jogme/yetis-keyboard/pictures/version1_1.JPG

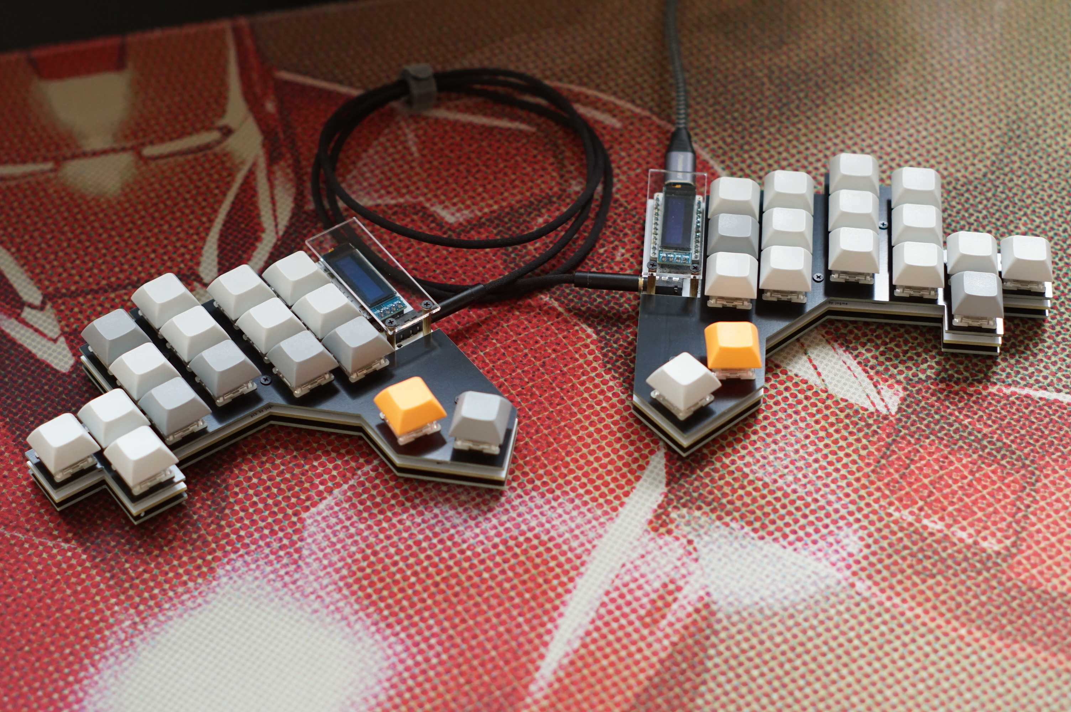
pictures/version1_1.JPG
