jogme/yetis-keyboard/(commit log)

2022-08-23 Initial commit
    - Add layout pics
    - Add scheme for one side
    - Add footprint for one side
    [yeti.kicad_pcb, yeti.kicad_sch]
2022-08-23 Restructe files into directories
    [yeti.kicad_pcb, yeti.kicad_sch]
2022-08-26 Enhancments and adding edge to pcb
    [yeti.kicad_pcb]
2023-02-14 Add case and fix pcb
    [case.FCStd, case_left.FCStd, case_right.FCStd, top_plate.FCStd, top_plate_right.FCStd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]
2023-02-14 pcb: Fix serial pin for jack
    [yeti.kicad_pcb, yeti.kicad_sch]
2023-02-14 pcb: Revert right-hand LED order
    When RGB_MODE_KNIGHT (qmk) is played, the knight rider should go
    visually correct (not jumping from bottom to top when transitioning
    to the other hand)
    [yeti.kicad_pcb, yeti.kicad_sch]
2023-03-09 pcb: Change microcontroller
    - Changing elite c to FROOD microcontroller (rp2040) from 42keebs.eu
    as it is a newer version of microcontroller, cheaper and has better
    performance.
    - Removing reset button as the button is included on the
    microcontroller and anyway who doesn't just shorts the pins..
    [yeti.kicad_pcb, yeti.kicad_sch]
2023-03-20 Move the key placement to a more suitable position
    First try to make a better layout of the keys.
    The alpha version had too big spaces between the keys in columns.
    The thumb key also adjusted.
    Did some rewire to look better
    [yeti.kicad_pcb]
2023-04-01 Move fingers closer
    - Move 3 fingers closer to index finger by ~1.5mm
    - Move ring finger up by ~1.5mm
    [yeti.kicad_pcb]
2023-04-02 Change the cut margin
    Use 45 degree cuts instead of arbitrary degrees
    [yeti.kicad_pcb]
2023-04-02 Add oled display support
    [yeti.kicad_pcb, yeti.kicad_sch]
2023-04-05 Adjust pinky finger positions
    [yeti.kicad_pcb]
2023-04-05 Adjust some routes
    [yeti.kicad_pcb]
2023-04-06 Place the yeti logo to silkscreen
    and the casual play with the roads
    [yeti.kicad_pcb]
2023-04-06 yeti v1 \o/
    [yeti.kicad_pcb]
2023-04-18 Add drill holes to the new version
    [yeti.kicad_pcb]
2023-04-24 gerber: Plot gerber for new version
    [yeti-B_Cu.gbl, yeti-B_Mask.gbs, yeti-B_Paste.gbp, yeti-B_Silkscreen.gbo, yeti-Edge_Cuts.gm1, yeti-F_Cu.gtl, yeti-F_Mask.gts, yeti-F_Paste.gtp]
2023-11-15 Directory cleanup
    [case.FCStd, case_left.FCStd, case_right.FCStd, top_plate.FCStd, top_plate_right.FCStd]
2023-11-15 Add case for version 1
    [v1.FCStd, v1_right.FCStd]
2023-11-15 pcb: Fix issues with multicontroller
    - Add pin labels
    - Make pin holes slightly bigger
    [yeti.kicad_pcb]
2023-11-15 case: Add reference pics used
2023-11-15 pcb-case: Add bottom plate with art
    [v1.FCStd, v1_right.FCStd, yeti_case.kicad_pcb, yeti_case.kicad_sch]
2023-11-15 case: Rearrange dirs and add top plate
    [yeti_case.kicad_pcb, yeti_case.kicad_sch]
2023-11-15 gitignore: Ignore case backup files
2023-11-15 pcb: Way to one pcb design
    - reversible oled pins
    - both sided jack
    - LEDs on the front side too
    - silkscreen on the back
    [yeti.kicad_pcb, yeti.kicad_sch]
2023-11-15 pcb: Fix label sync issues between pcb and schematic
    [yeti.kicad_pcb, yeti.kicad_sch]
2023-11-15 Fix issues with backside switches
    - Added footprint for trrs
    - Added footprint for mx switches
    - Fixed switches on thee pcbs back
    [yeti.kicad_pcb, yeti.kicad_sch]
2023-11-15 pcb: fix some issues
    [yeti.kicad_pcb]
2023-11-22 pcb: Fix pin layout on the back
    [yeti.kicad_pcb]
2023-11-22 pcb: fix some routes
    [yeti.kicad_pcb]
2023-11-22 Version 1.1 is out!
    [yeti.kicad_pcb]
2023-11-22 Rename to yetiS
    [yetis.kicad_pcb, yetis.kicad_sch, yetis_bottom.kicad_pcb, yetis_bottom.kicad_sch, yetis_top.kicad_pcb, yetis_top.kicad_sch]
2023-11-25 Remove gerber files
    [yeti-B_Cu.gbl, yeti-B_Mask.gbs, yeti-B_Paste.gbp, yeti-B_Silkscreen.gbo, yeti-Edge_Cuts.gm1, yeti-F_Cu.gtl, yeti-F_Mask.gts, yeti-F_Paste.gtp]
2023-11-25 pcb: Fix mismoved silksrceen label
    [yetis.kicad_pcb]
2024-07-11 Some changes, probably caused by new kicad version
